AndreaPuzo/reflex/README.md

# reflex
Human reflex test using Arduino Micro
